goran-mahovlic/MIPI-CSI-2-HDMI-Bridge/PCB/GateMate1_CamBoard_prototypeCamBoard_PCB_Schematic_preliminary_final.pdf

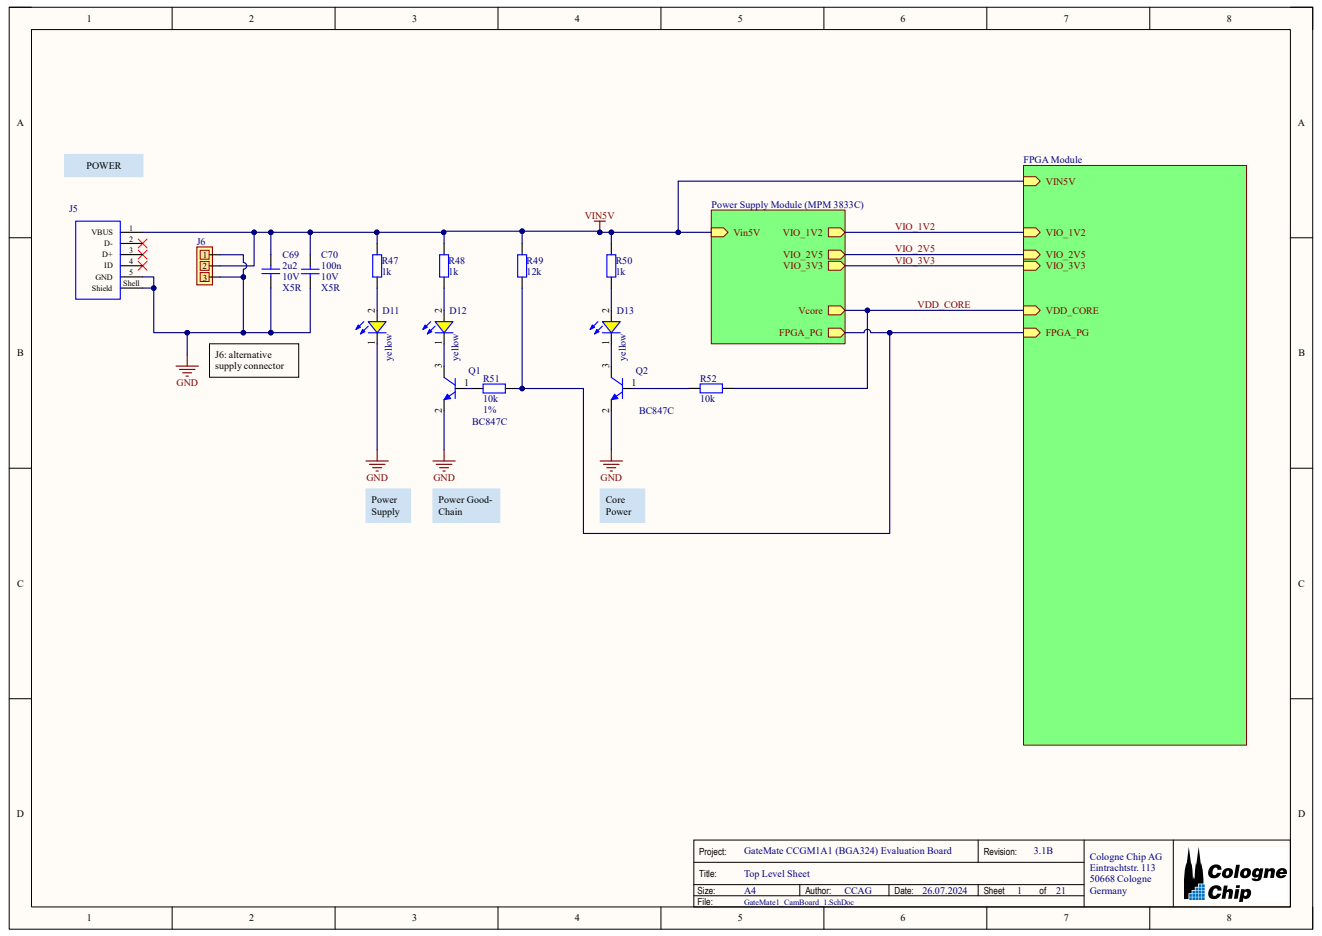
[picture p1: page 1]

Power Supply Module (MPM 3833C)

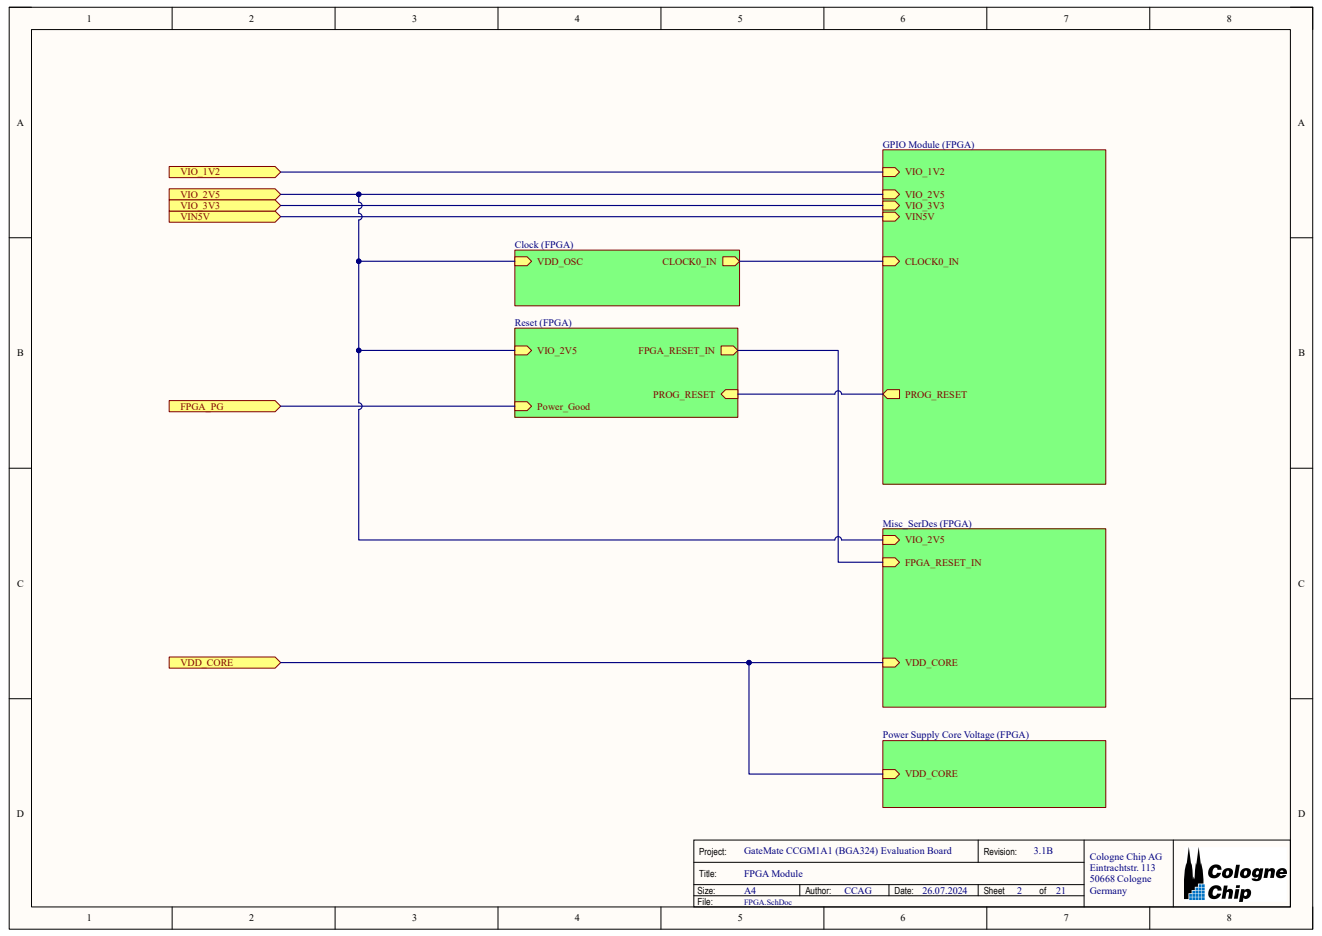
[picture p2: page 2]
FPGA Module; FPGA.SchDoc; Revision:; Author: CCAG; 21 Sheet; Project:; Cologne Chip AG; VDD_CORE; VIN5V; CLOCK0_IN; VIO_1V2; VIO_2V5 VIO_3V3; PROG_RESET; FPGA_PG; Power_Good; VIO_2V5; FPGA_RESET_IN; Reset (FPGA); VDD_OSC; Clock (FPGA); Misc_SerDes (FPGA)

GPIO Module (FPGA)

Power Supply Core Voltage (FPGA)

GateMate CCGM1A1 (BGA324) Evaluation Board

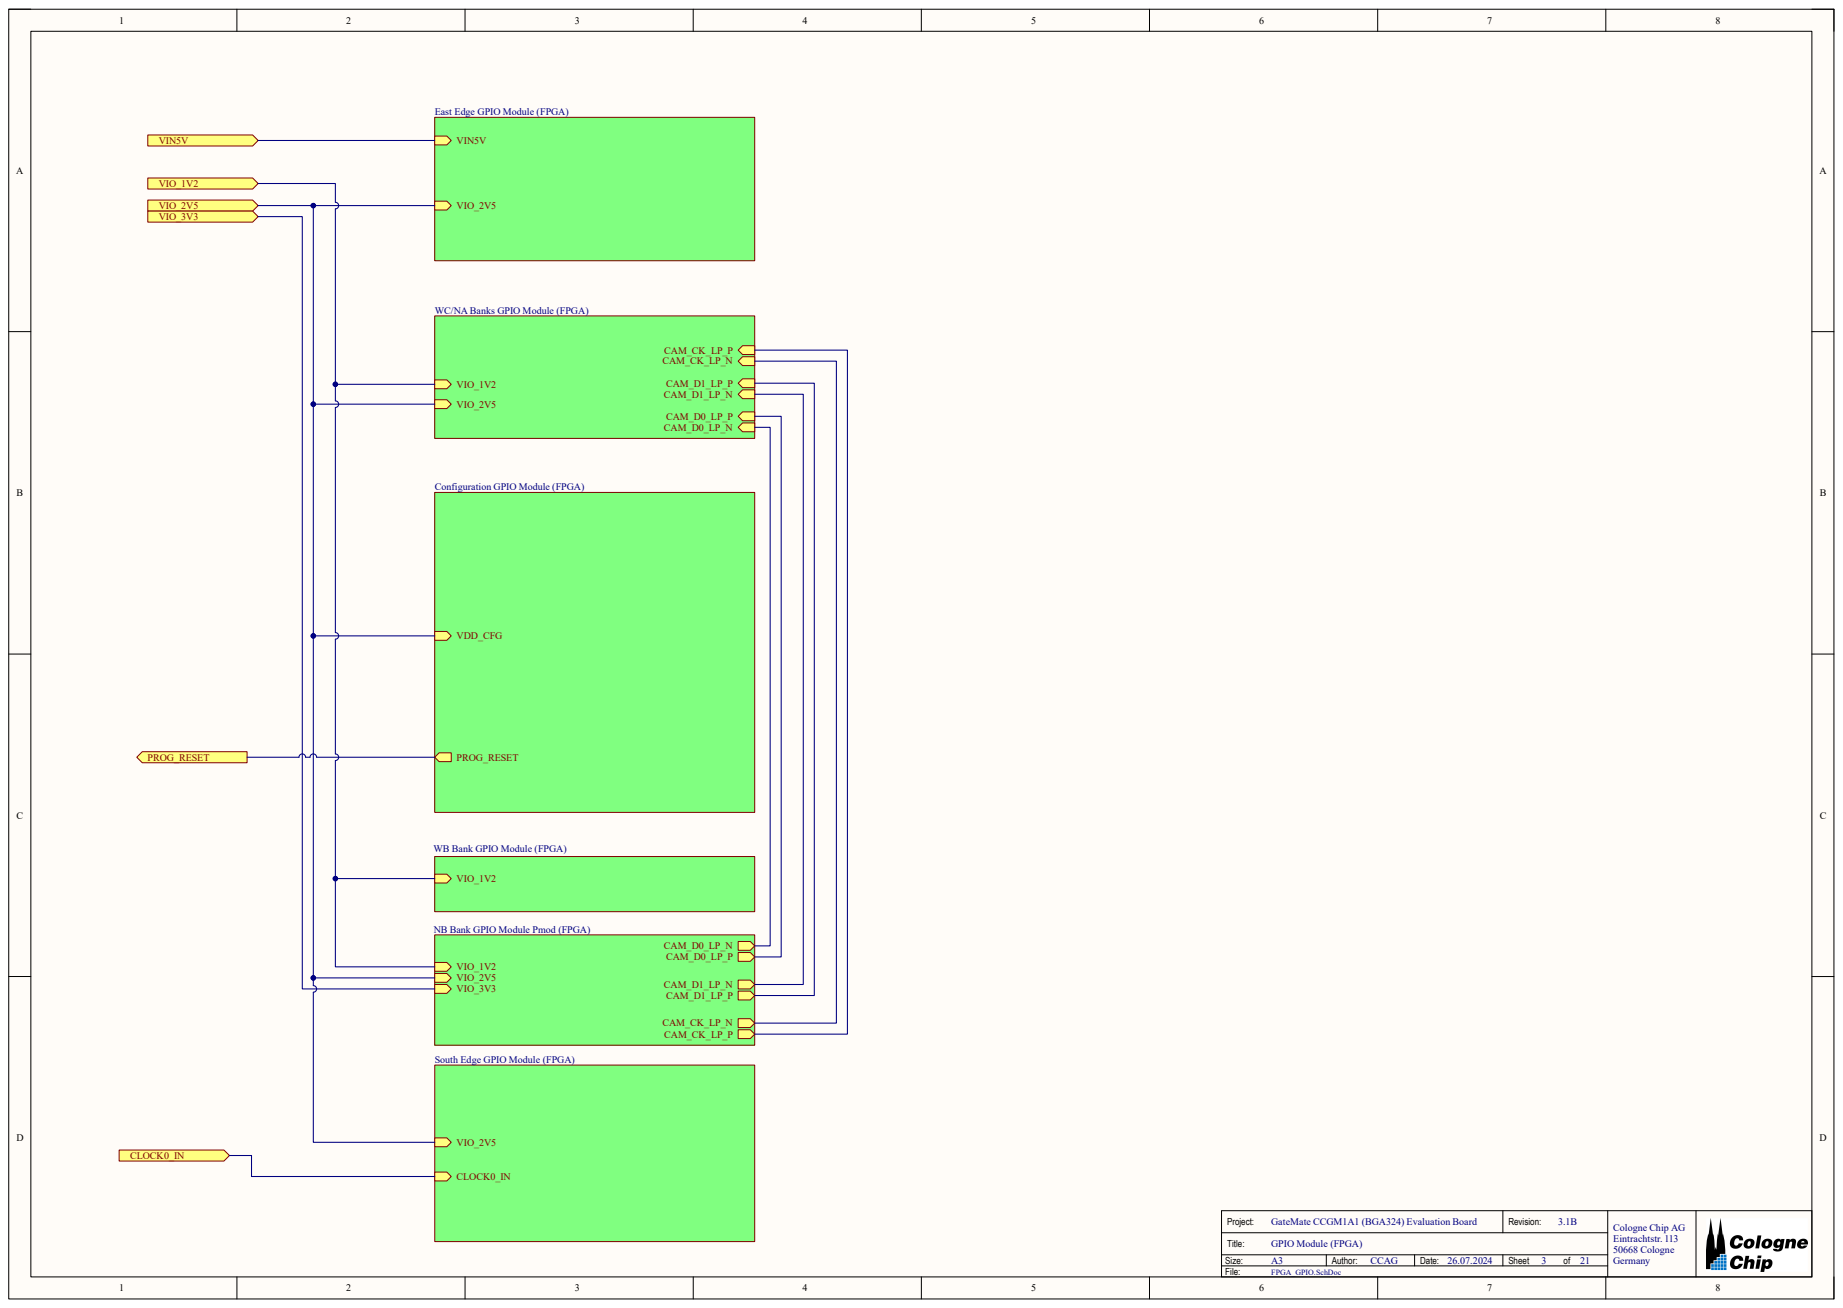
[picture p3: page 3]
Revision:; Author: CCAG; 21 Sheet; Project:; Cologne Chip AG; VIN5V; VIO_2V5; VIO_1V2; CAM_D0_LP_N; CAM_D0_LP_P; CAM_D1_LP_N; CAM_D1_LP_P; CAM_CK_LP_N; CAM_CK_LP_P; CLOCK0_IN; VDD_CFG; PROG_RESET; VIO_2V5 VIO_3V3; CAM_D0_LP_N CAM_D0_LP_P; CAM_D1_LP_N CAM_D1_LP_P; CAM_CK_LP_N CAM_CK_LP_P

East Edge GPIO Module (FPGA)

WC/NA Banks GPIO Module (FPGA)

Configuration GPIO Module (FPGA)

WB Bank GPIO Module (FPGA)

NB Bank GPIO Module Pmod (FPGA)

South Edge GPIO Module (FPGA)

GateMate CCGM1A1 (BGA324) Evaluation Board

GPIO Module (FPGA)
FPGA_GPIO.SchDoc

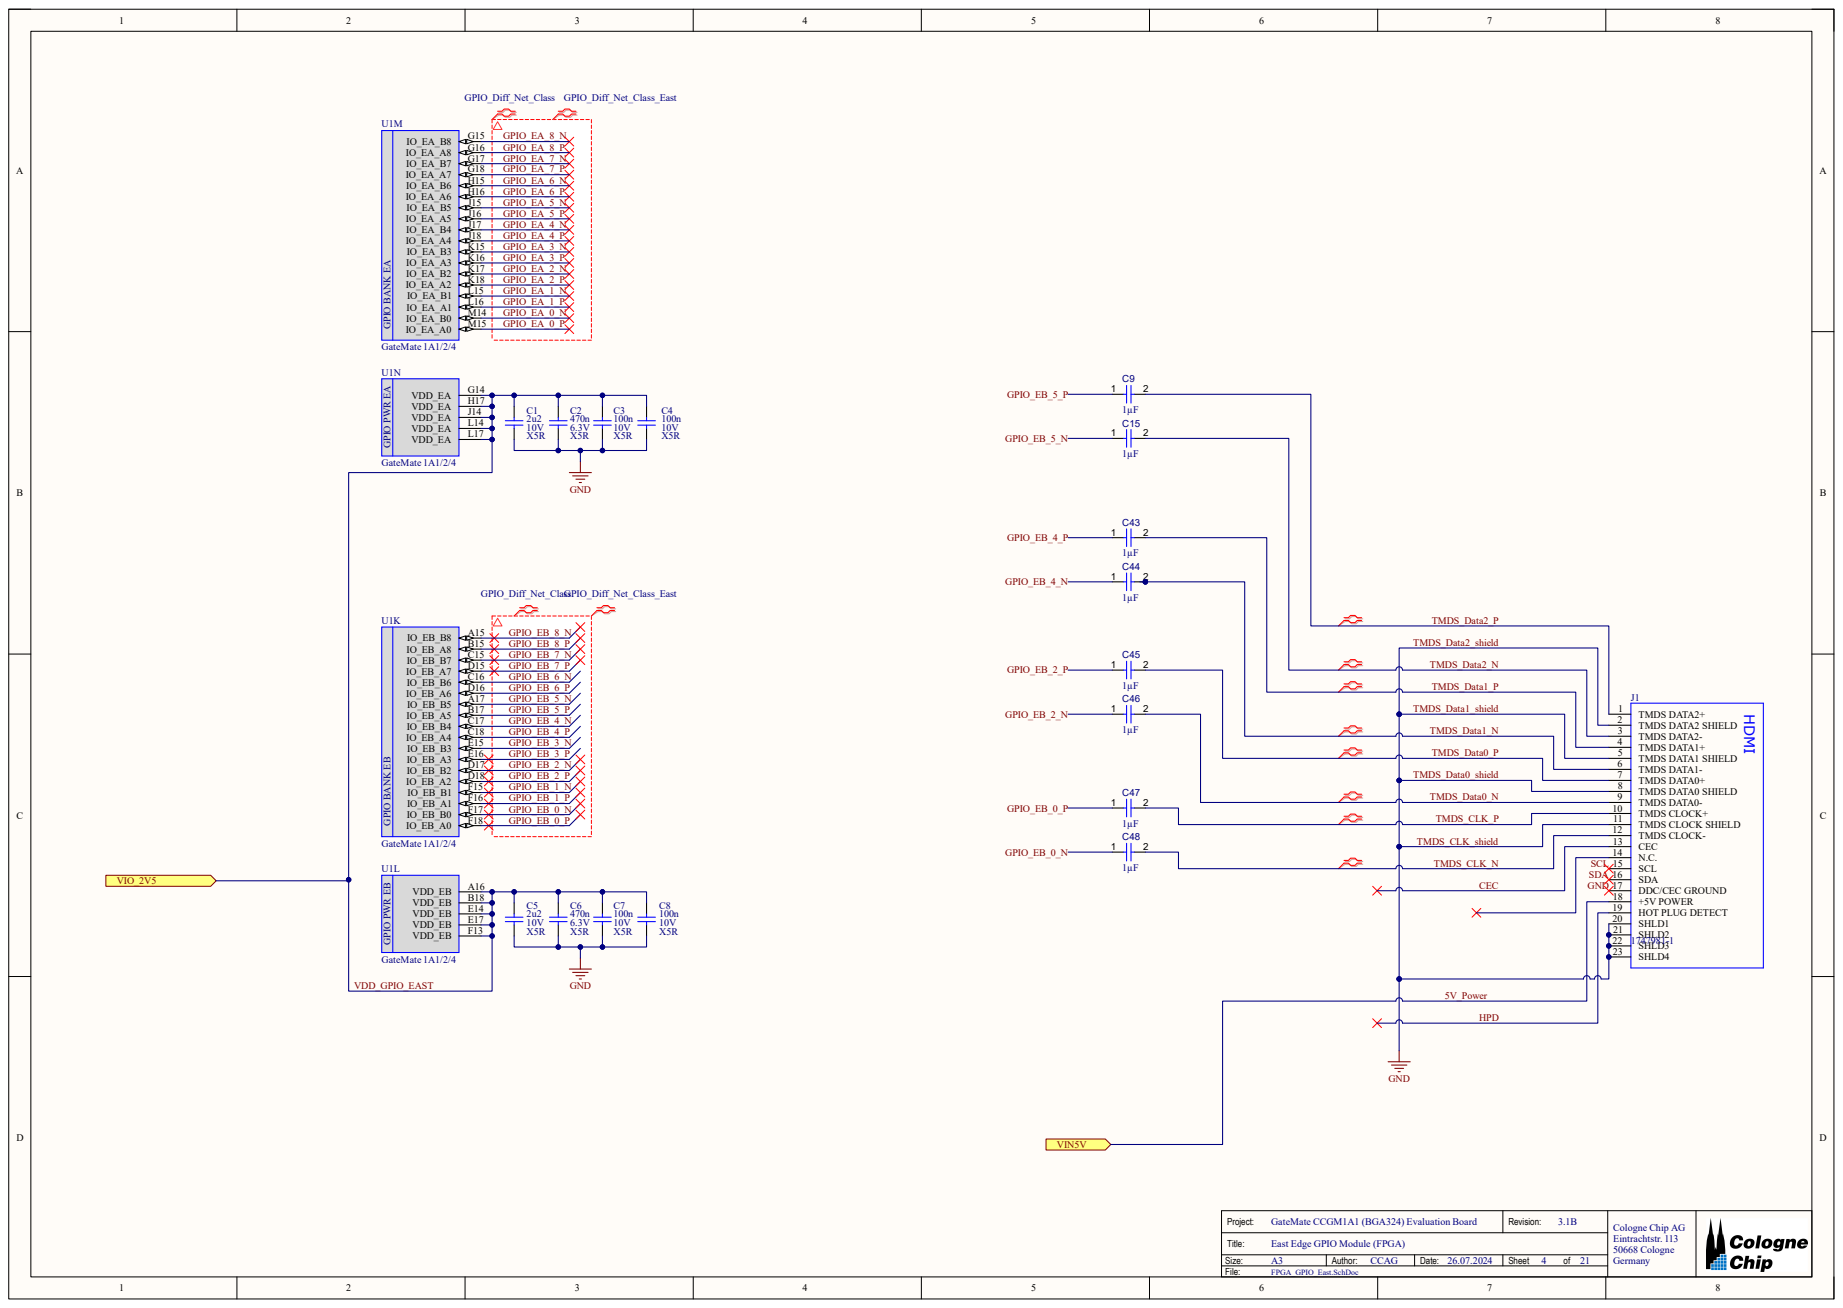
[picture p4: page 4]

East Edge GPIO Module (FPGA)
FPGA_GPIO_East.SchDoc

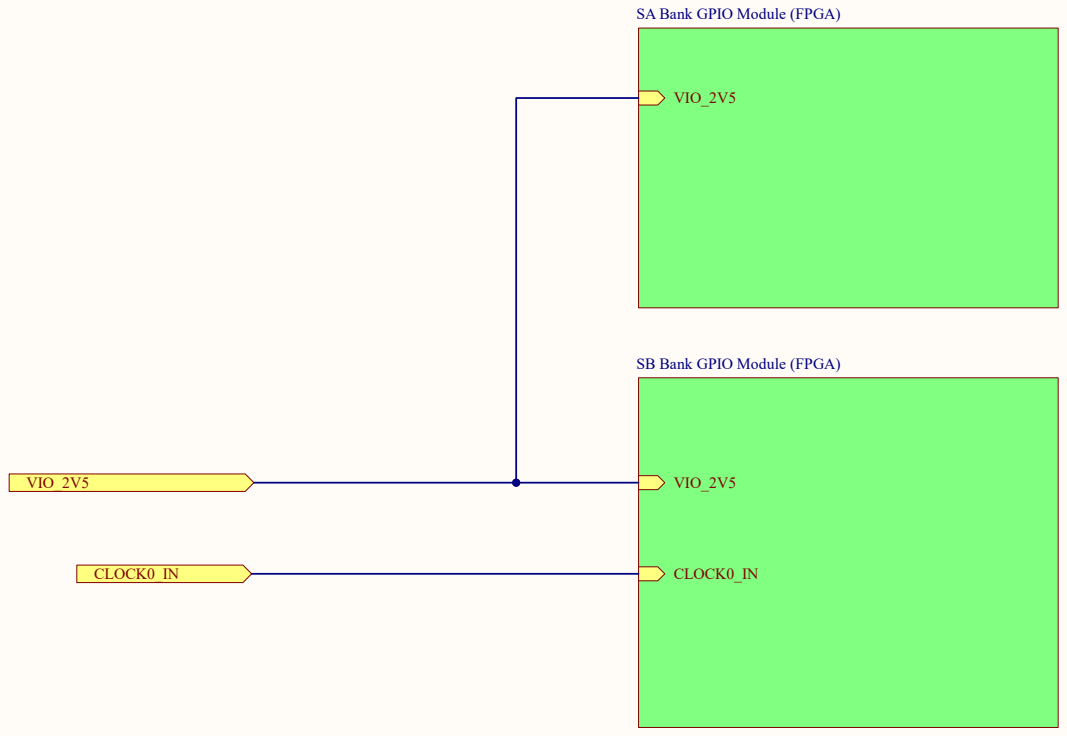
[picture p5: page 5]
Revision:; Author: CCAG; 21 Sheet; Project:; Cologne Chip AG; VIO_2V5; CLOCK0_IN

SA Bank GPIO Module (FPGA)

SB Bank GPIO Module (FPGA)

GateMate CCGM1A1 (BGA324) Evaluation Board

South Edge GPIO Module (FPGA)
FPGA_GPIO_South.SchDoc

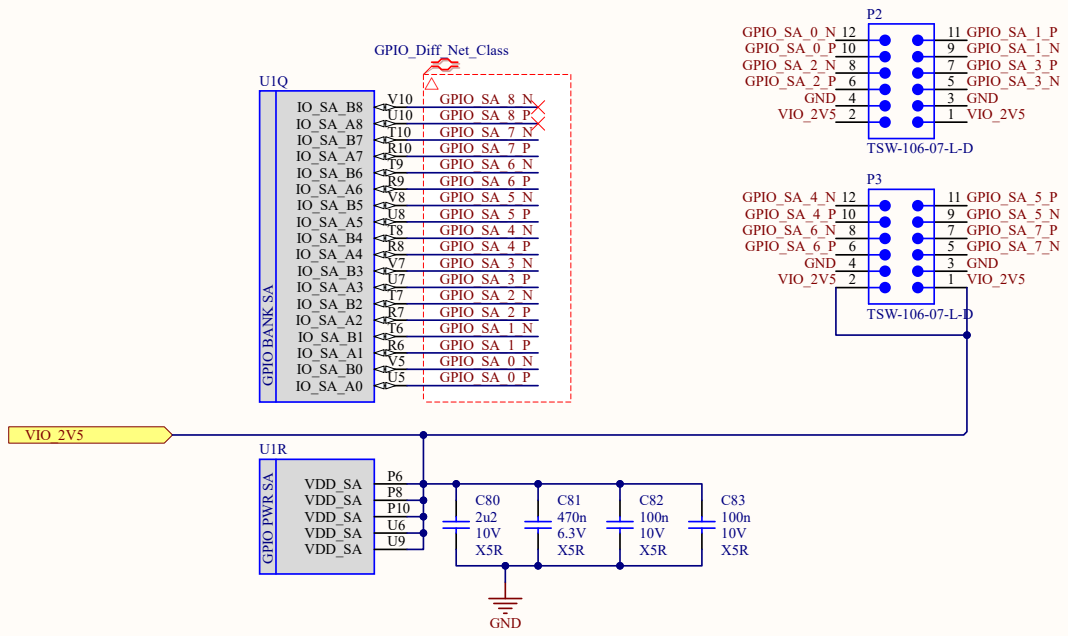
[picture p6: page 6]

SA Bank GPIO Module (FPGA)
FPGA_GPIO_SA.SchDoc

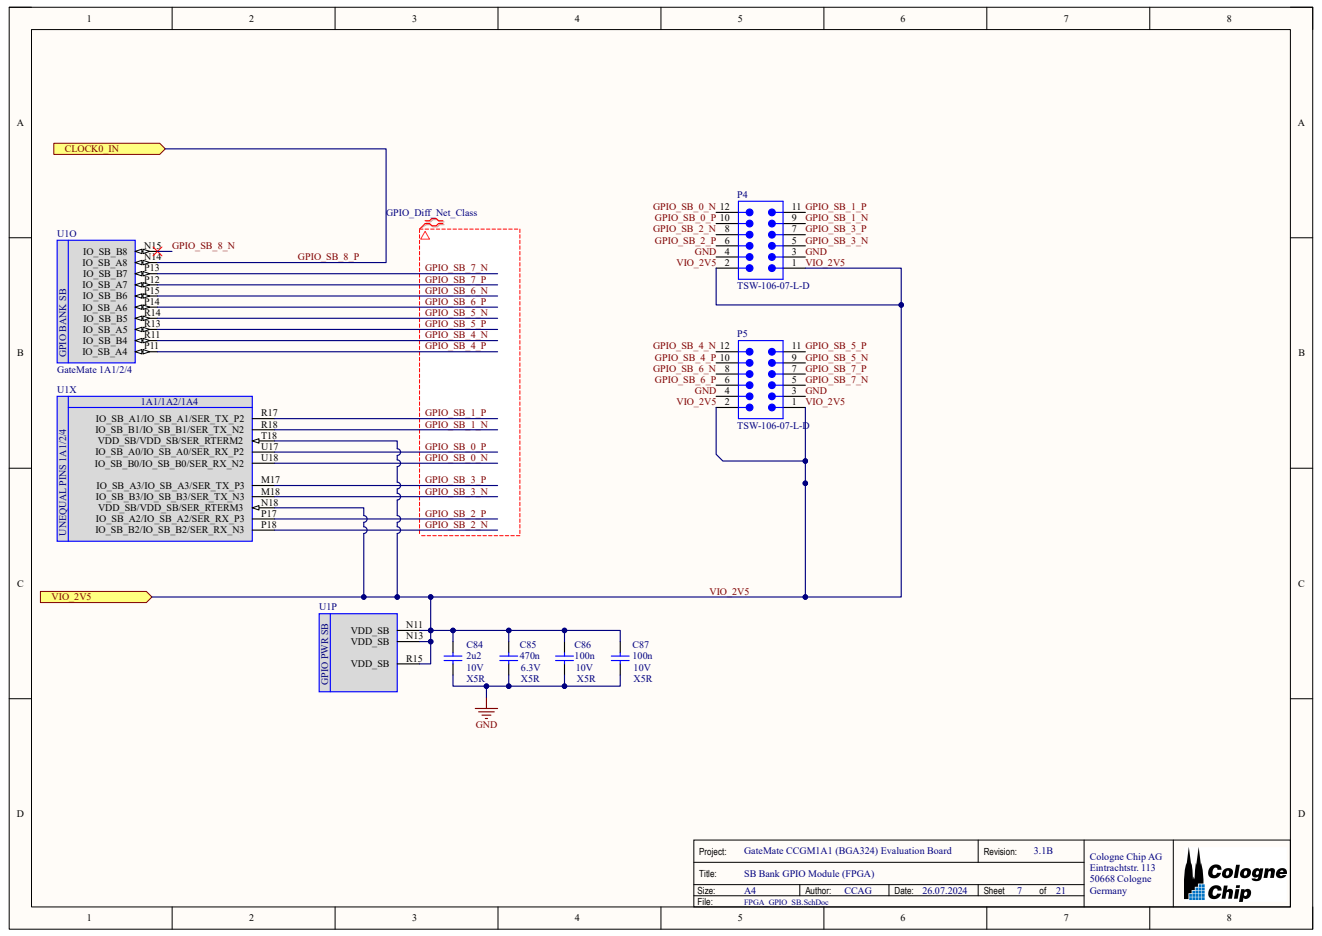
[picture p7: page 7]

SB Bank GPIO Module (FPGA)
FPGA_GPIO_SB.SchDoc

GND GPIO PWR WA | VDD_WA | N5

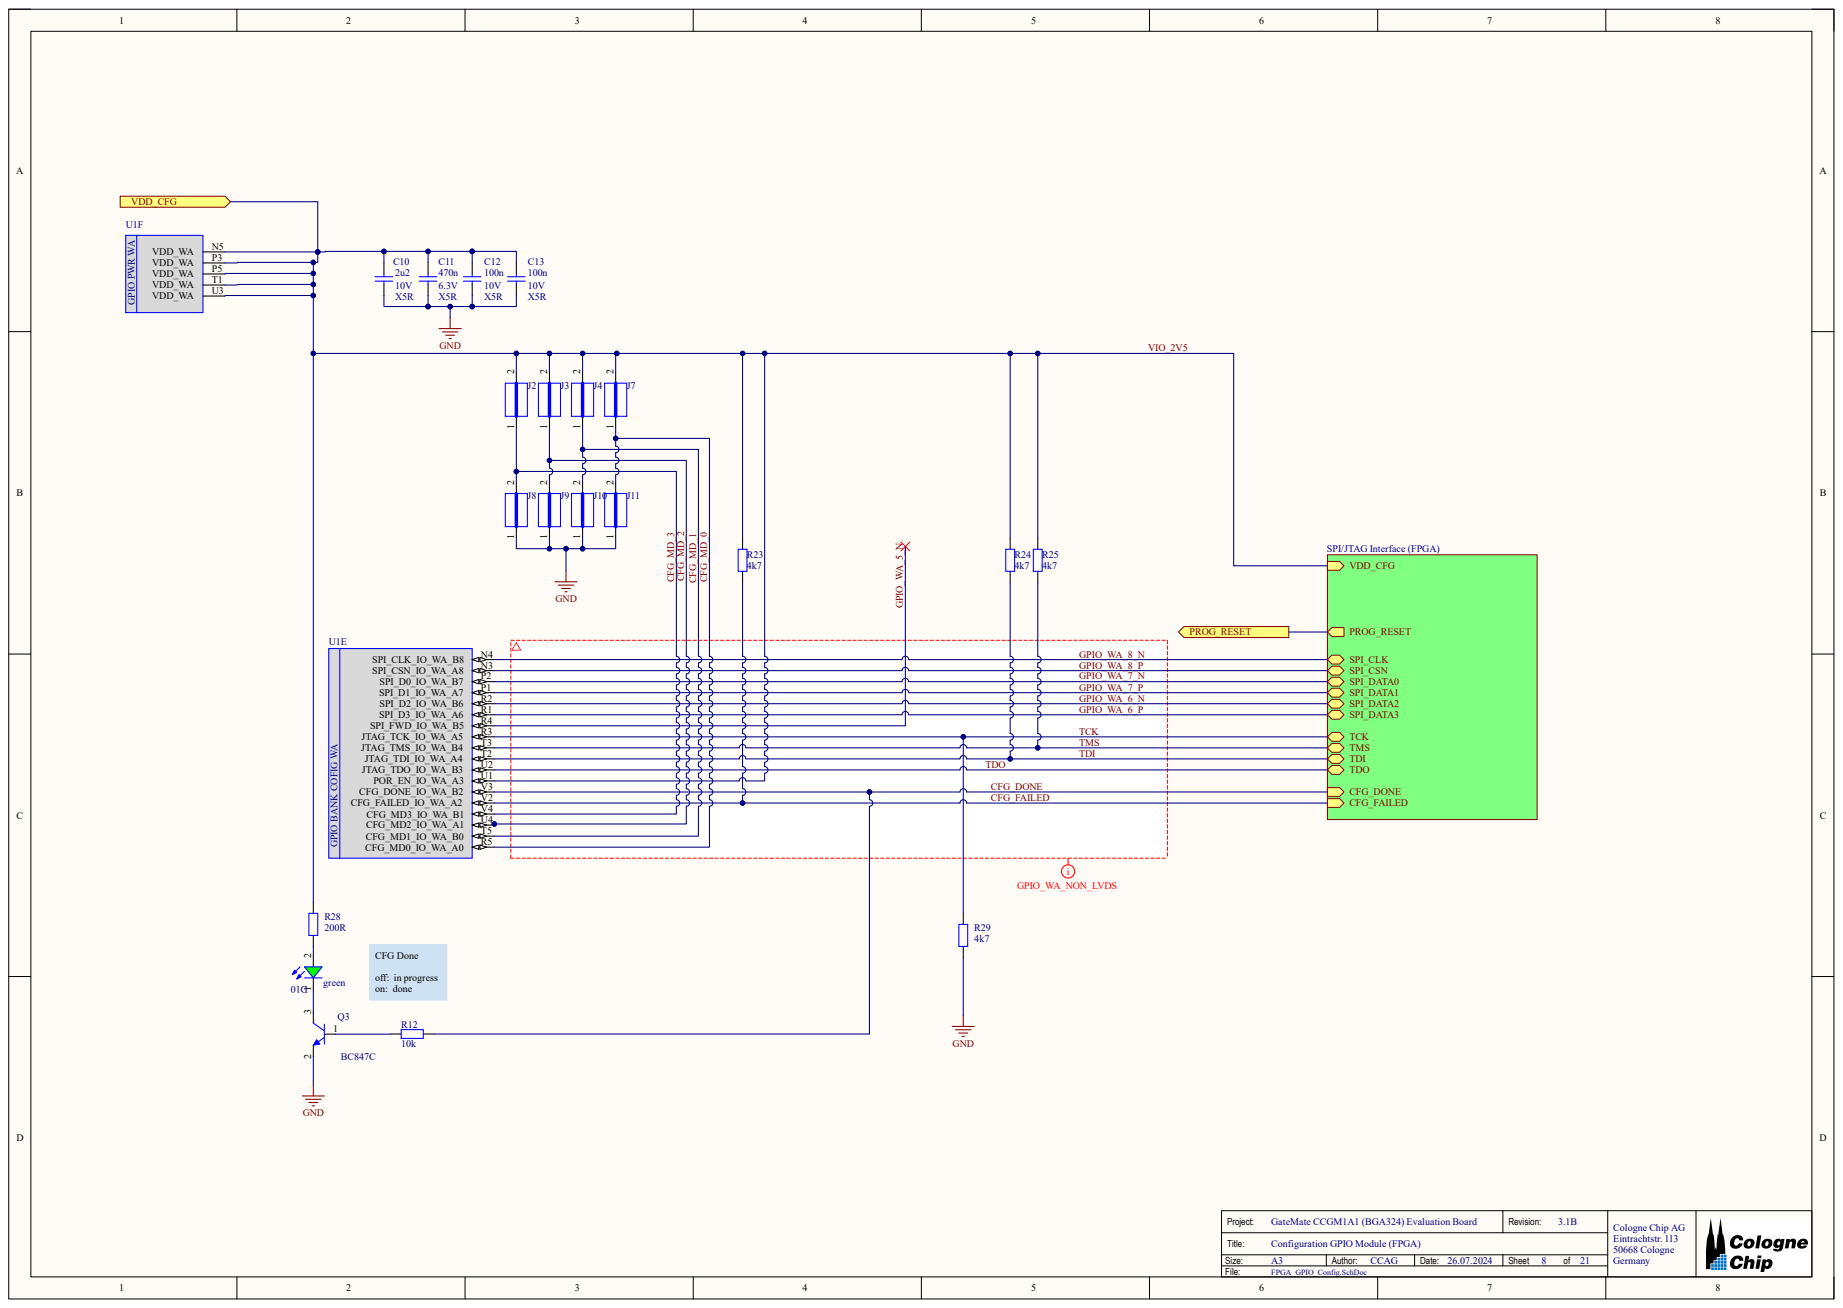
[picture p8: page 8]

SPI/JTAG Interface (FPGA)
VDD_CFG

Configuration GPIO Module (FPGA)
FPGA_GPIO_Config.SchDoc

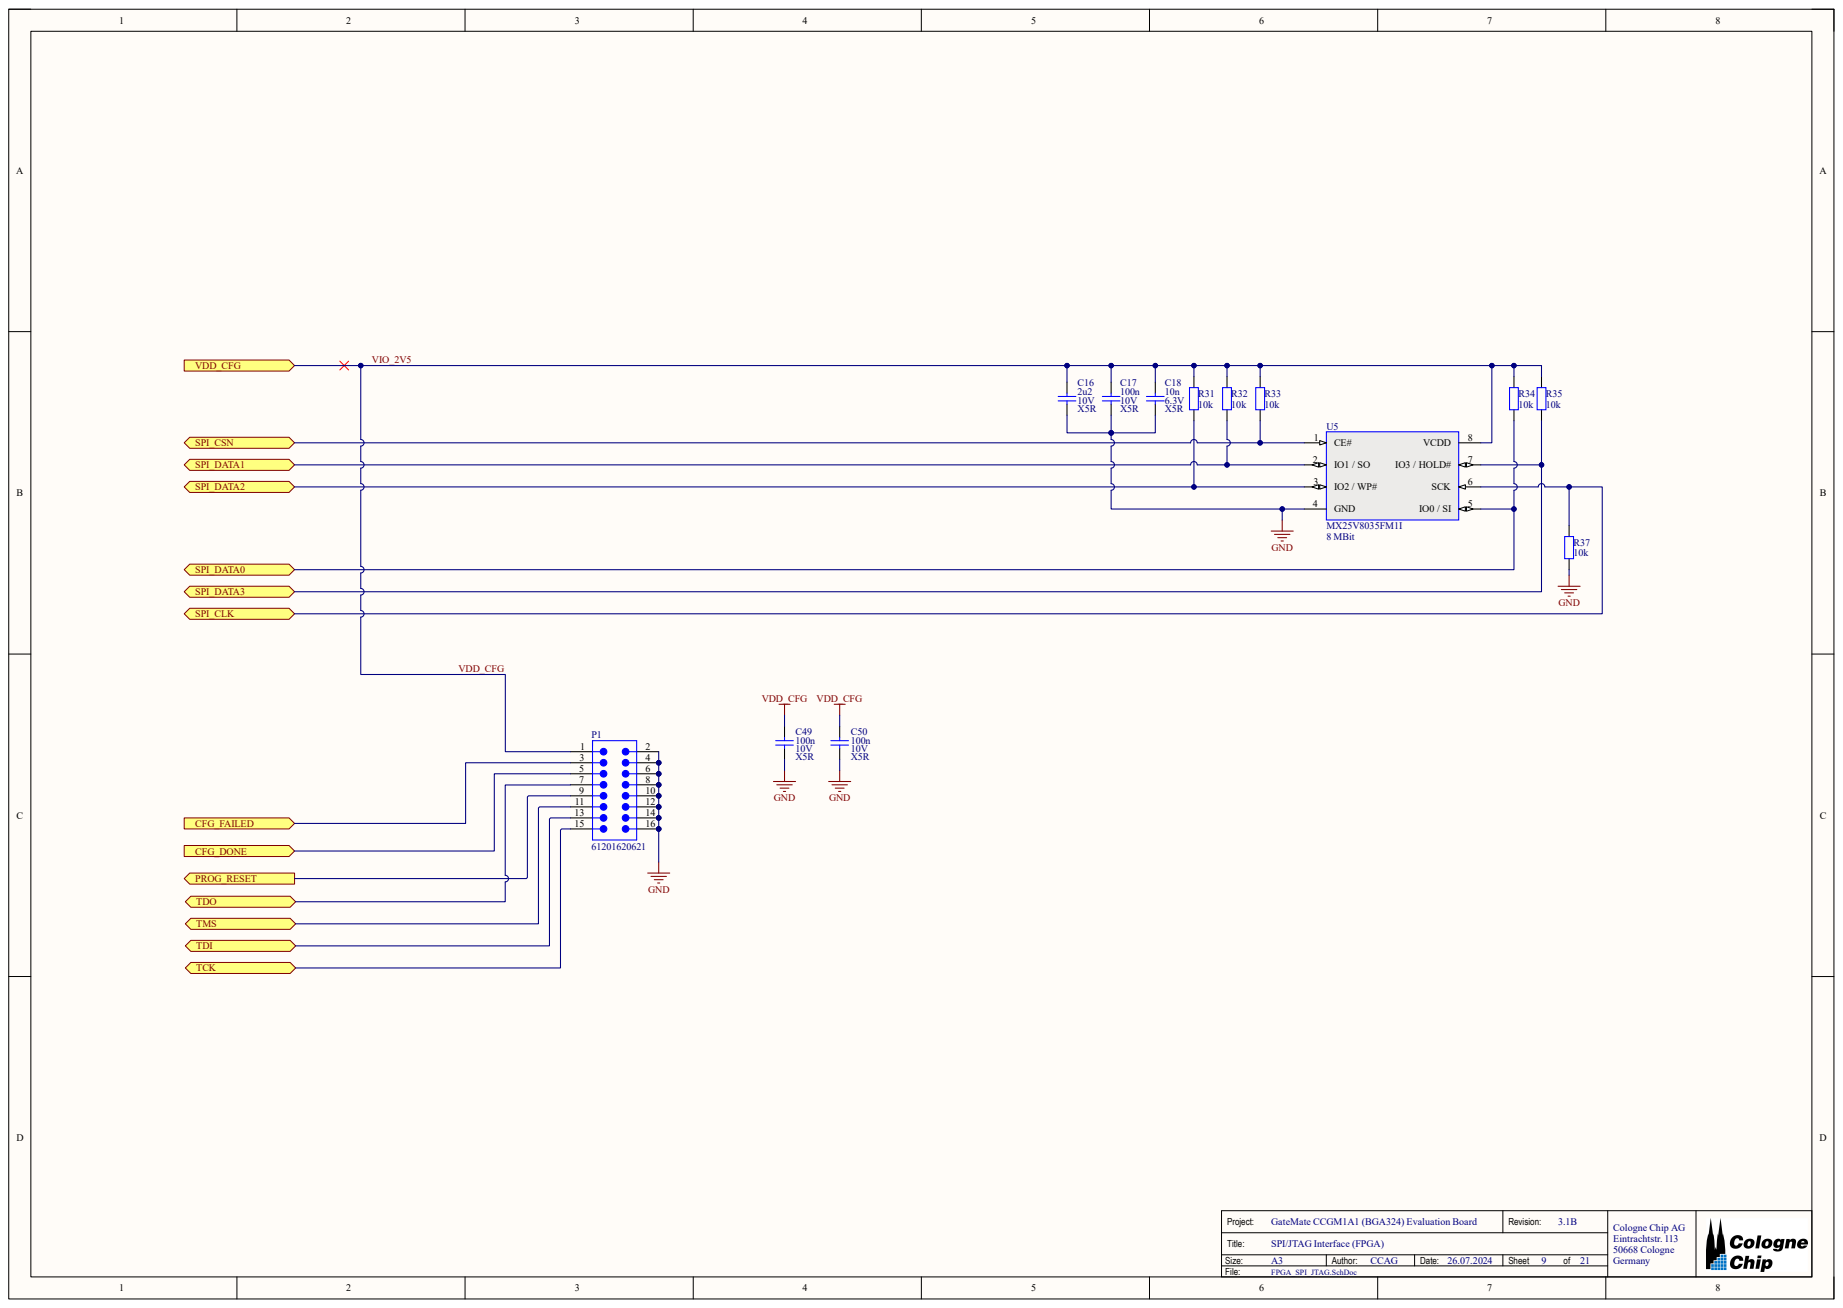
[picture p9: page 9]

SPI/JTAG Interface (FPGA)
FPGA_SPI_JTAG.SchDoc

IO_WB_A0 | N1 IO_WB_B0 | N2 GPIO BANK WB | IO_WB_A1 | M3 IO_WB_B1 | M4 IO_WB_A2 | L3 IO_WB_B2 | L4 IO_WB_A3 | L1 IO_WB_B3 | L2 IO_WB_A4 | K3 IO_WB_B4 | K4 IO_WB_A5 | K1 IO_WB_B5 | K2 IO_WB_A6 | J3 IO_WB_B6 | J4 IO_WB_A7 | H1 IO_WB_B7 | H2 IO_WB_A8 | H3 IO_WB_B8 | H4

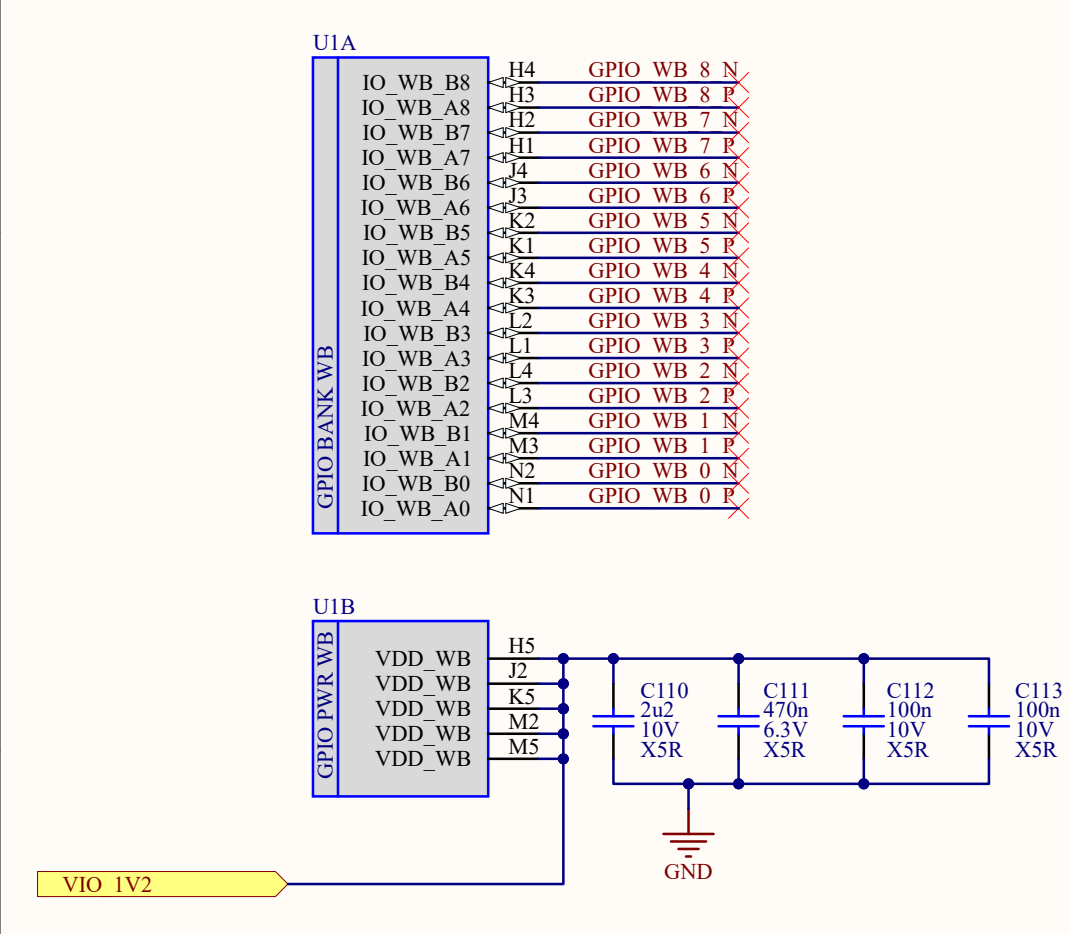
[picture p10: page 10]
Revision:; Author: CCAG; 21 Sheet; Project:; Cologne Chip AG; GND; VDD_WB; M5 GPIO PWR WB; M2 VDD_WB; K5 VDD_WB; J2 VDD_WB; VIO_1V2; GPIO_WB_2_N GPIO_WB_2_P GPIO_WB_1_N GPIO_WB_1_P GPIO_WB_0_N GPIO_WB_0_P; GPIO_WB_8_P GPIO_WB_7_N GPIO_WB_7_P GPIO_WB_6_N GPIO_WB_6_P GPIO_WB_5_N GPIO_WB_5_P GPIO_WB_4_N GPIO_WB_4_P GPIO_WB_3_N GPIO_WB_3_P; GPIO_WB_8_N

GateMate CCGM1A1 (BGA324) Evaluation Board

WB Bank GPIO Module HyperBus (FPGA)
FPGA_GPIO_WB.SchDoc

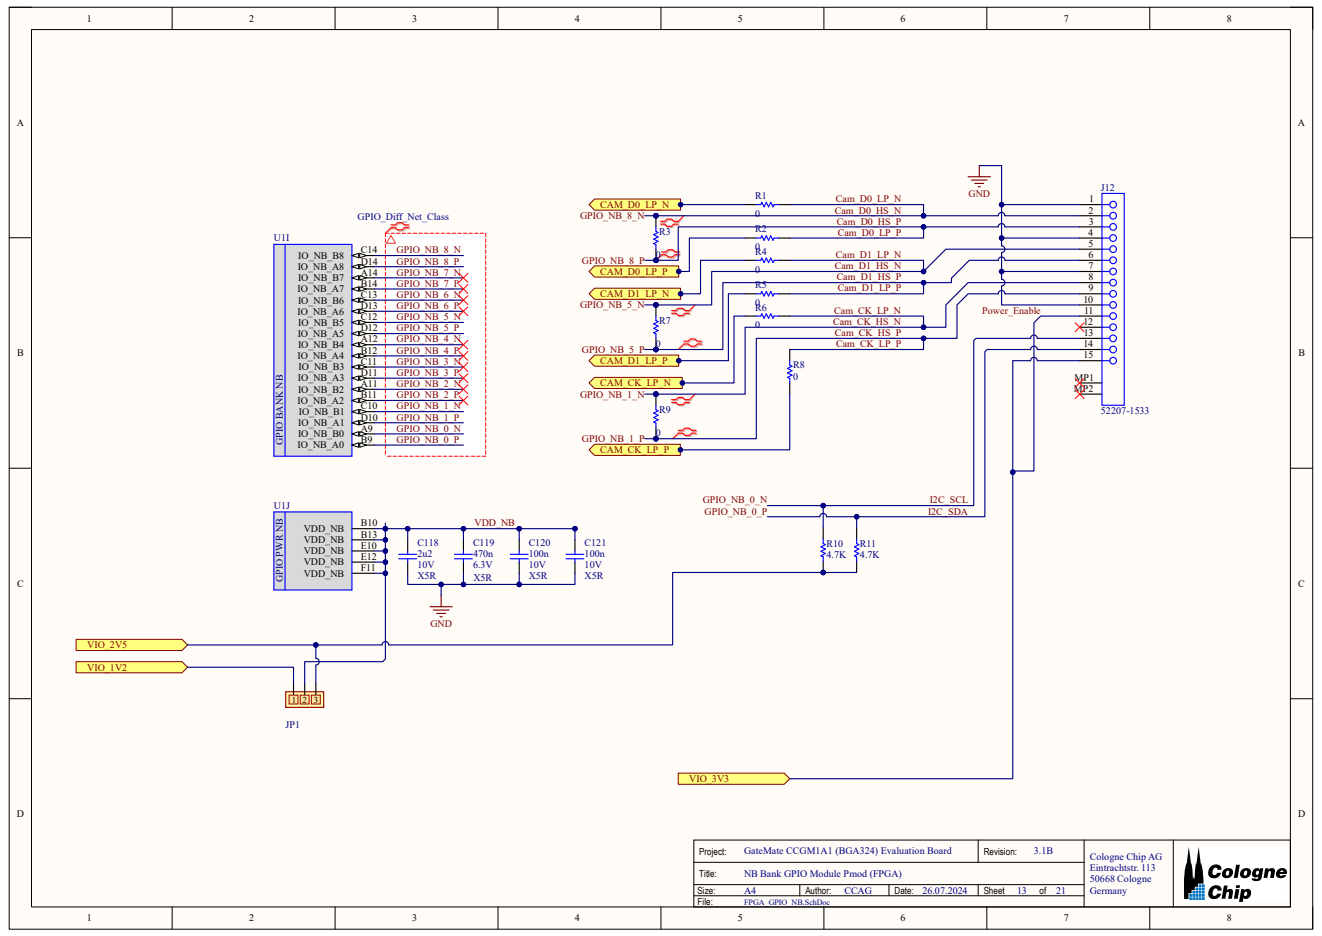
[picture p11: page 11]

NB Bank GPIO Module Pmod (FPGA)
FPGA_GPIO_NB.SchDoc

IO_WC_A0 | G1 IO_WC_B0 | G2 GPIO BANK WC | IO_WC_A1 | G3 IO_WC_B1 | G4 IO_WC_A2 | F3 IO_WC_B2 | F4 IO_WC_A3 | E1 IO_WC_B3 | E2 IO_WC_A4 | E3 IO_WC_B4 | E4 IO_WC_A5 | D1 IO_WC_B5 | D2 IO_WC_A6 | D3 IO_WC_B6 | D4 IO_WC_A7 | C3 IO_WC_B7 | C4 IO_WC_A8 | B1 IO_WC_B8 | B2

# GPIO_WC_8_N VDDIO_WC_NA

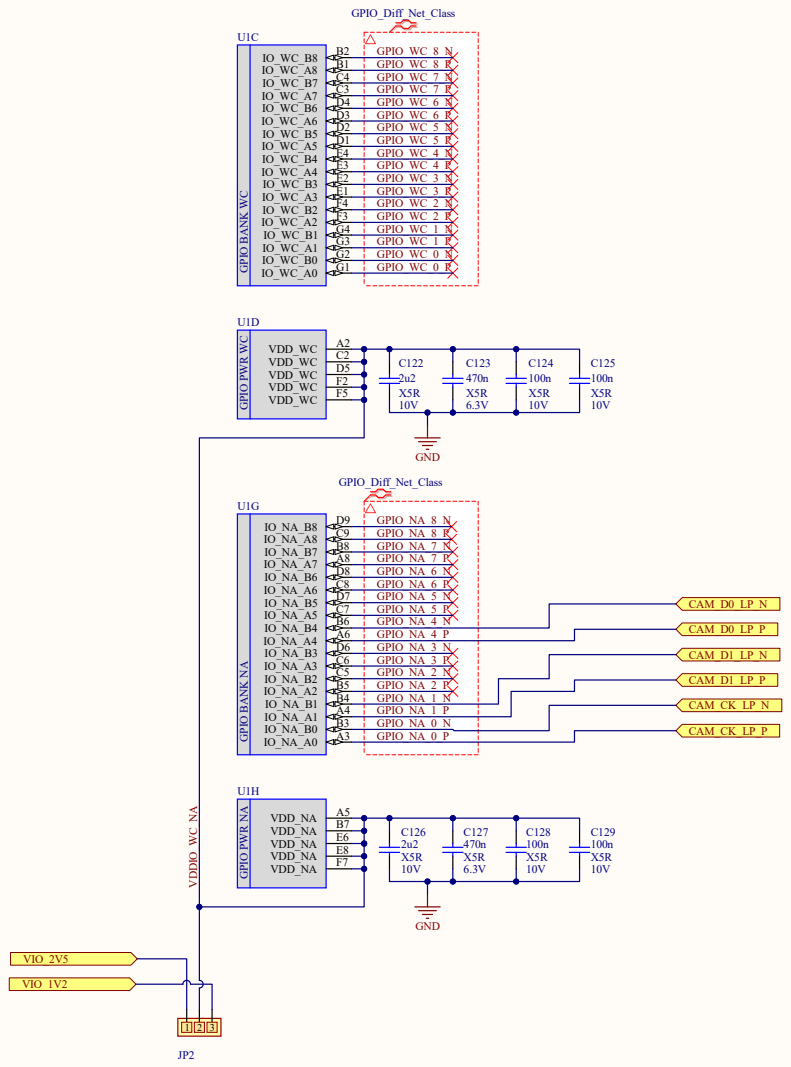
[picture p12: page 12]

WC/NA Banks GPIO Module (FPGA)
FPGA_GPIO_WC_NA.SchDoc

VDD L12 | VDD L10 | VDD L8 | VDD L6 | VDD K13 | VDD K11 | VDD K9 | VDD K7 | VDD J12 | VDD J10 | VDD J8 | VDD J6 | VDD H13 | VDD H11 | VDD H9 | VDD H7 | VDD G12 | VDD G10 | VDD G8 | VDD G6 | VDD F9
GND | V18 GND | V9 GND | V6 GND | V1 GND | U15 GND | T17 GND | T11 GND | T4 GND | R16 GND | R12 GND | P9 GND | P7 GND | P4 GND | N17 GND | N12 GND | N9 GND | N7 GND | M16 GND | M12 GND | M10 GND | M8 GND | M6 GND | M1 GND | L18 GND | L13 GND | L11 GND | L9 GND | L7 GND | L5 GND | K14 GND | K12 GND A1

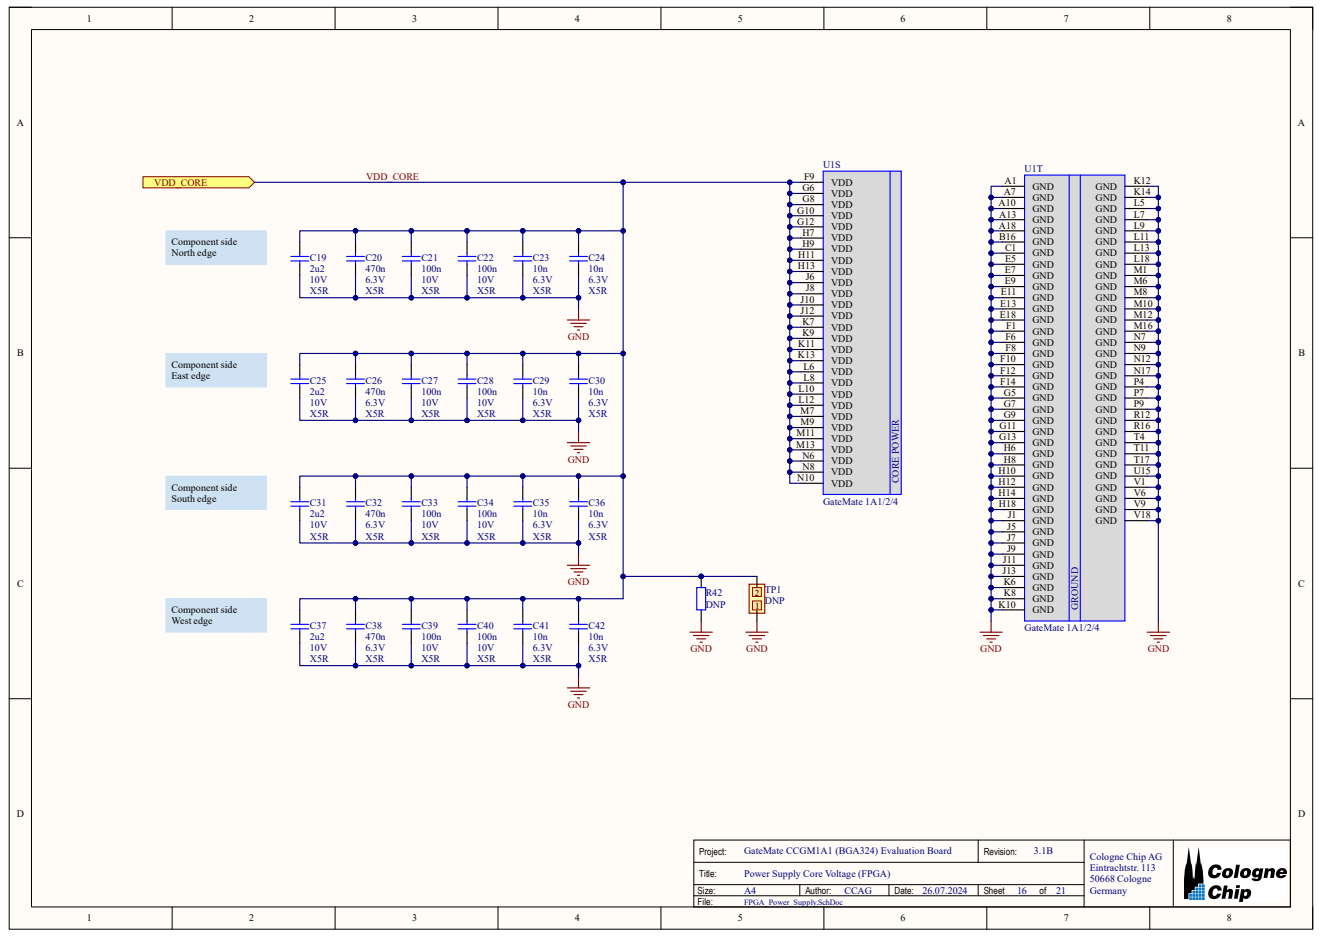
[picture p13: page 13]

Power Supply Core Voltage (FPGA)
FPGA_Power_Supply.SchDoc

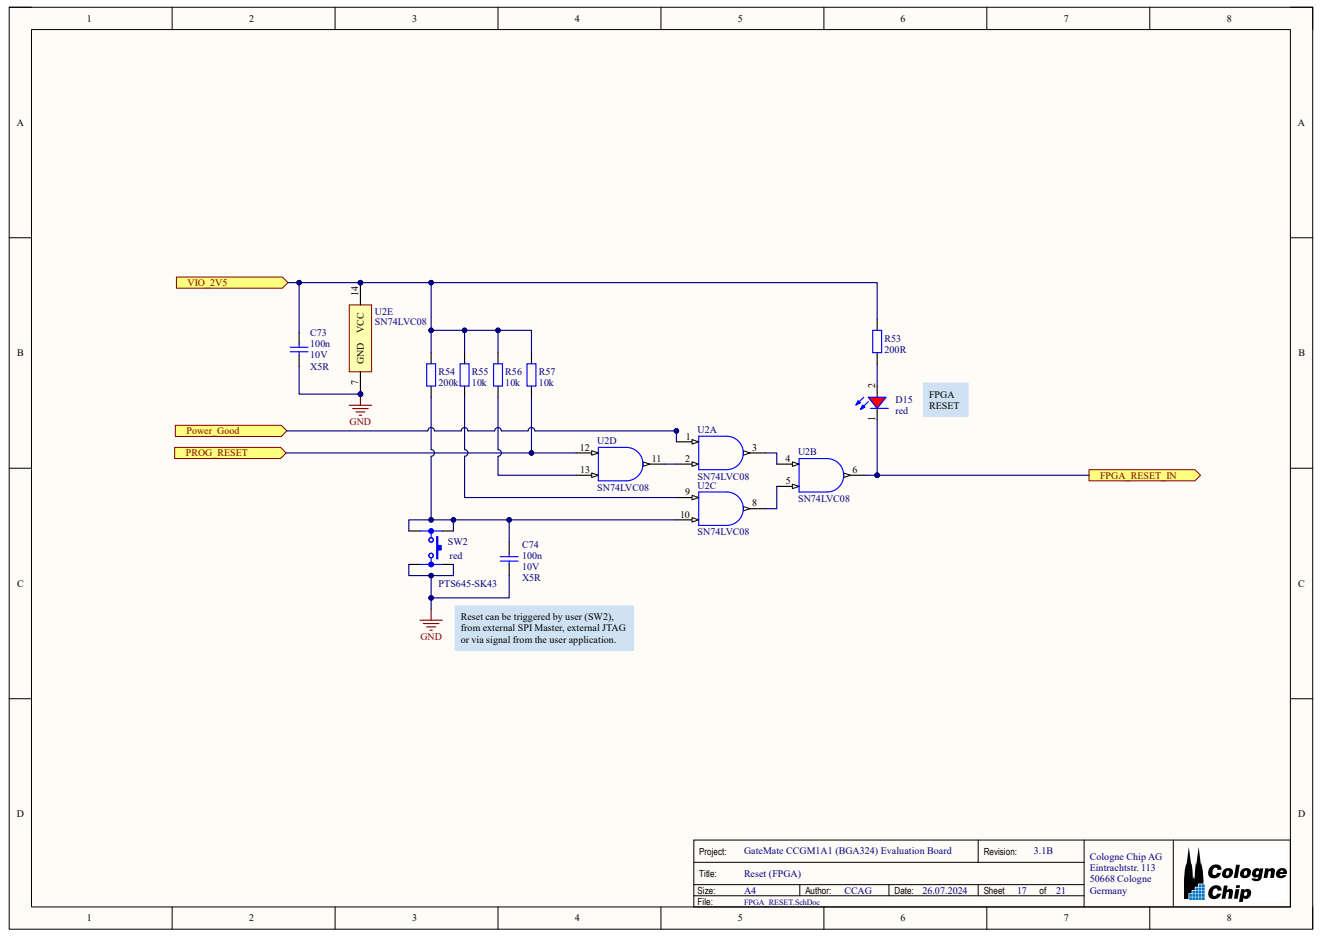
[picture p14: page 14]

Reset can be triggered by user (SW2),
from external SPI Master, external JTAG
or via signal from the user application.

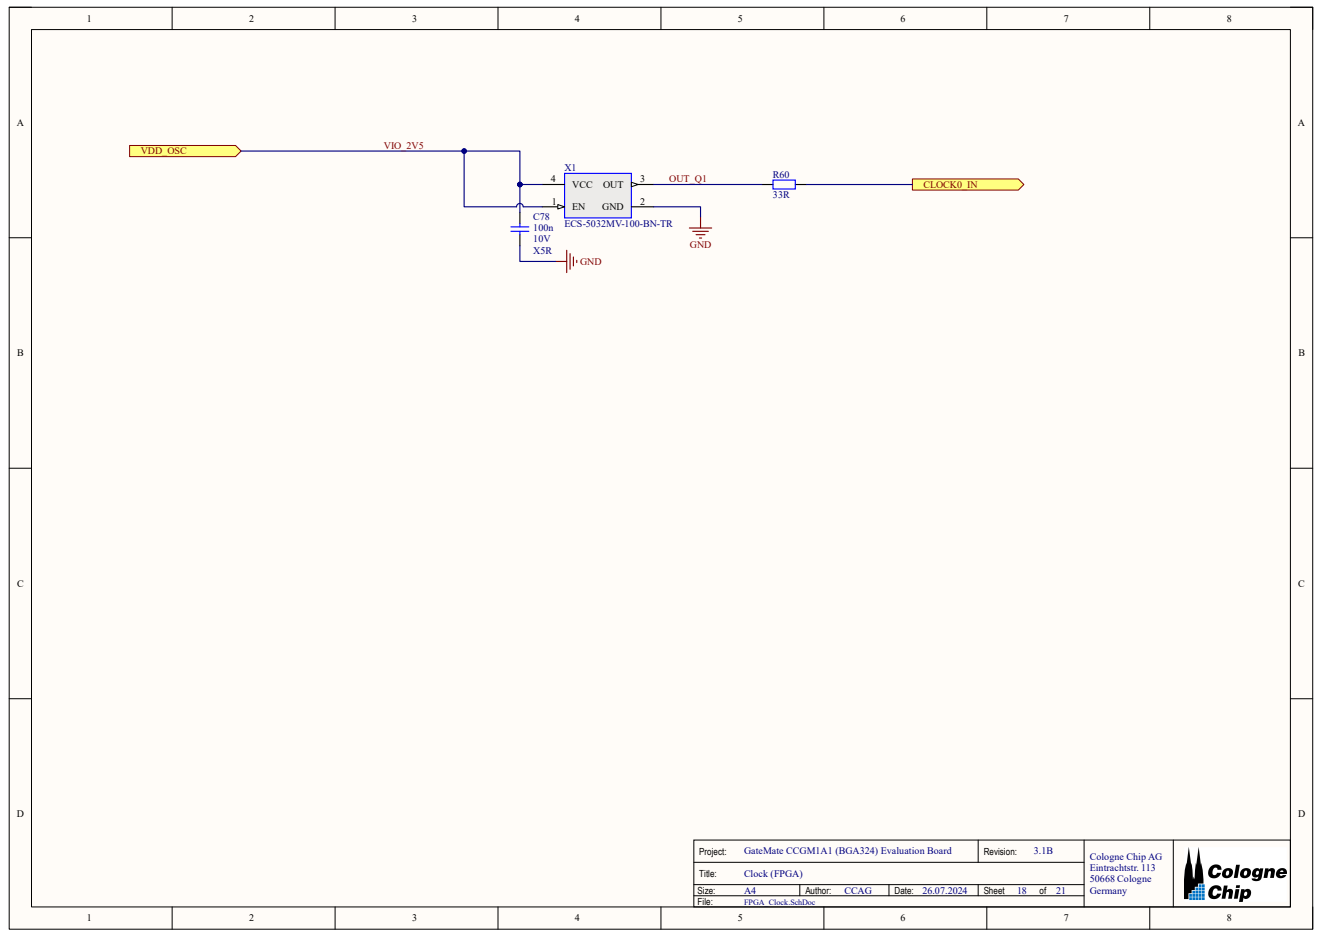
[picture p15: page 15]
Clock (FPGA); FPGA_Clock.SchDoc; Revision:; Author: CCAG; 21 Sheet; Project:; Cologne Chip AG; CLOCK0_IN; VDD_OSC; GND 10V X5R; GND; OUT; 3 VCC 4; ECS-5032MV-100-BN-TR; OUT_Q1; VIO_2V5

GateMate CCGM1A1 (BGA324) Evaluation Board

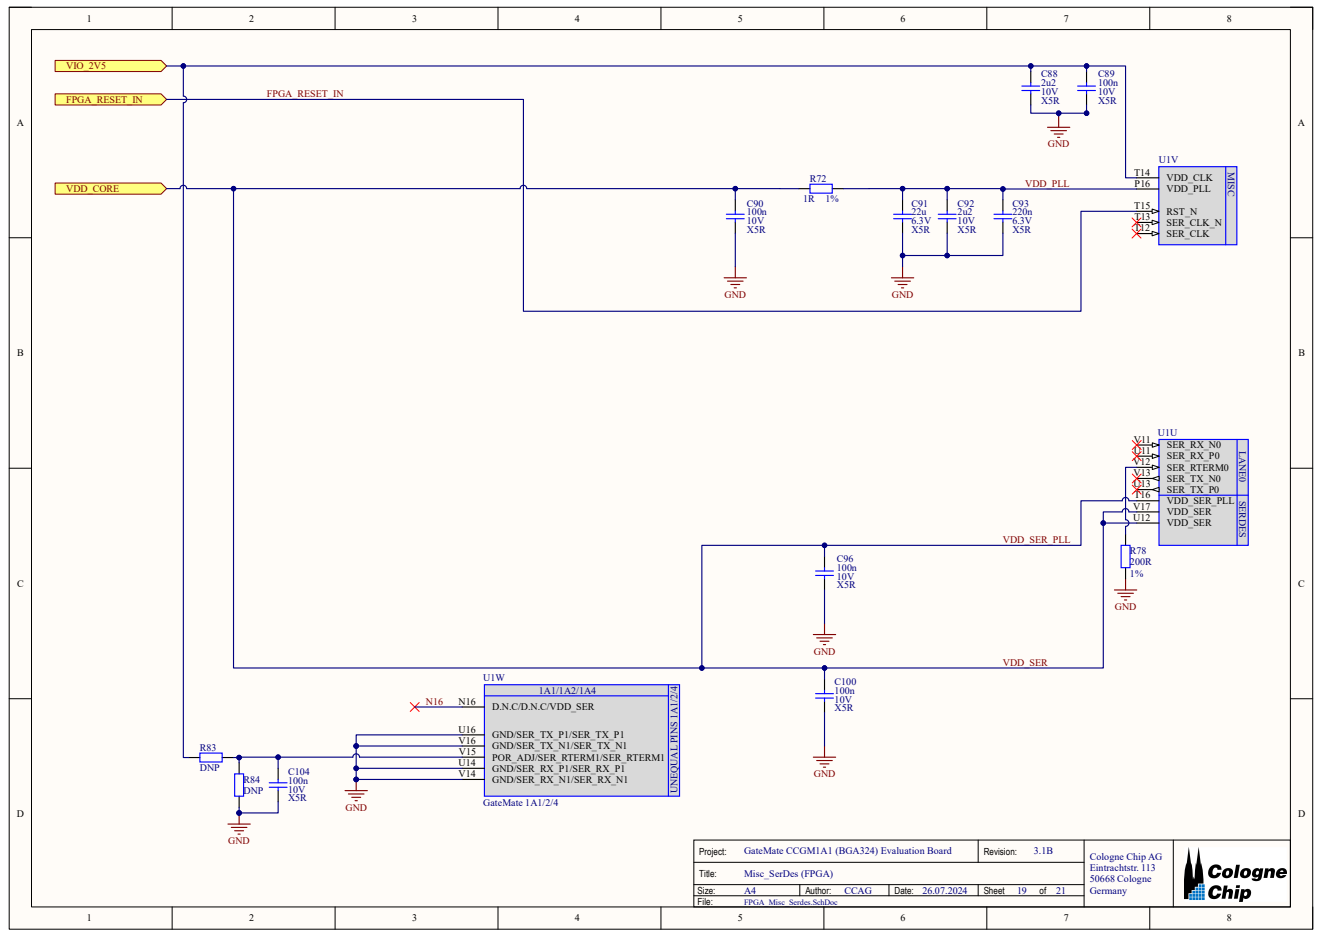
[picture p16: page 16]

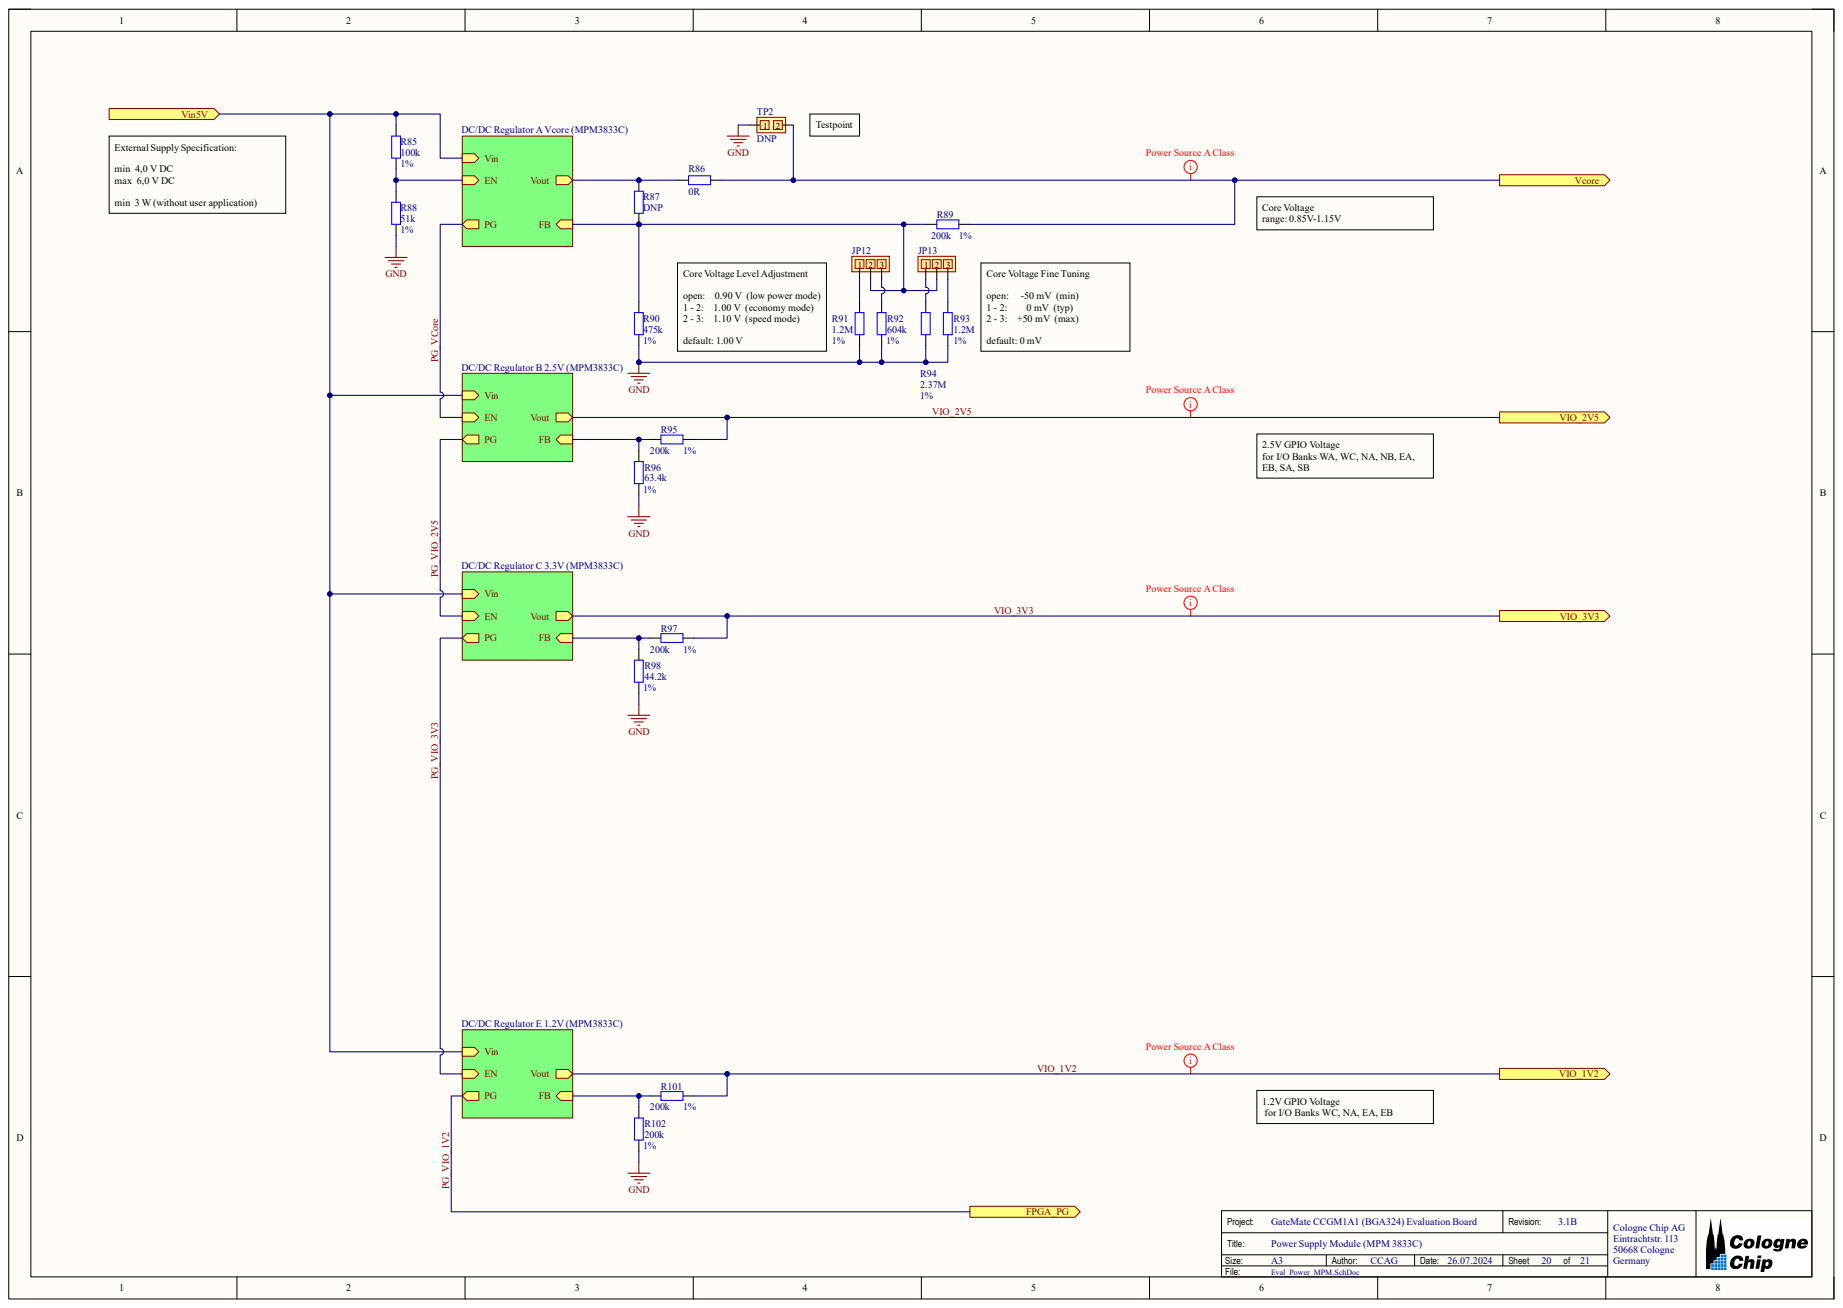
[picture p17: page 17]

DC/DC Regulator A Vcore (MPM3833C)

min 3 W (without user application)

Core Voltage Level Adjustment

Core Voltage Fine Tuning

open: 0.90 V (low power mode)
1 - 2: 1.00 V (economy mode)
2 - 3: 1.10 V (speed mode)

2.5V GPIO Voltage
for I/O Banks WA, WC, NA, NB, EA,

1.2V GPIO Voltage
for I/O Banks WC, NA, EA, EB

Power Supply Module (MPM 3833C)
Eval_Power_MPM.SchDoc

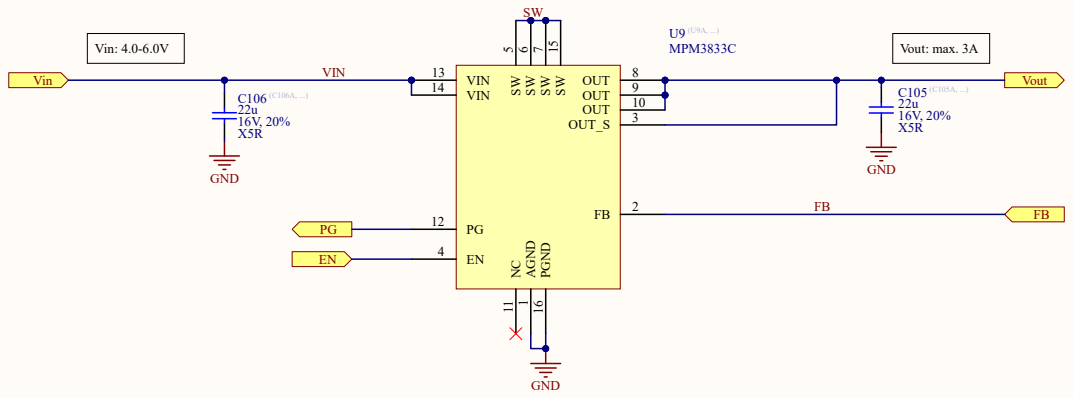
[picture p18: page 18]
Revision:; Author: CCAG; 21 Sheet; Project:; Cologne Chip AG; GND; VIN; VIN 13 VIN 14; OUT; OUT_S; 2 AGND; 1 PGND 16 SW; U9 ⁽U9A, ...) MPM3833C; Vout; Vin; Vin: 4.0-6.0V; Vout: max. 3A

GateMate CCGM1A1 (BGA324) Evaluation Board

DC/DC Regulator (MPM3833C)
Eval_dcdc_MPM3833C.SchDoc
