goran-mahovlic/MIPI-CSI-2-HDMI-Bridge/(list of files, drawings)

Other design files:
PCB/Eval_dcdc_MPM3833C.SchDoc
PCB/Eval_Power_MPM.SchDoc
PCB/FPGA.SchDoc
PCB/FPGA_Clock.SchDoc
PCB/FPGA_GPIO.SchDoc
PCB/FPGA_GPIO_Config.SchDoc
PCB/FPGA_GPIO_East.SchDoc
PCB/FPGA_GPIO_NB.SchDoc
PCB/FPGA_GPIO_SA.SchDoc
PCB/FPGA_GPIO_SB.SchDoc
PCB/FPGA_GPIO_South.SchDoc
PCB/FPGA_GPIO_WB.SchDoc
PCB/FPGA_GPIO_WC_NA.SchDoc
PCB/FPGA_Misc_Serdes.SchDoc
PCB/FPGA_Power_Supply.SchDoc
PCB/FPGA_RESET.SchDoc
PCB/FPGA_SPI_JTAG.SchDoc
PCB/GateMate1_CamBoard.PrjPcb
PCB/GateMate1_CamBoard_1.SchDoc
PCB/GateMate1_FPGA_FT2232h.SchDoc
